noemu/X360toNX/Controller.c

/*
             LUFA Library
     Copyright (C) Dean Camera, 2013.

  dean [at] fourwalledcubicle [dot] com
           www.lufa-lib.org
*/

/*
  Copyright 2013  Dean Camera (dean [at] fourwalledcubicle [dot] com)

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
  The author disclaims all warranties with regard to this
  software, including all implied warranties of merchantability
  and fitness.  In no event shall the author be liable for any
  special, indirect or consequential damages or any damages
  whatsoever resulting from loss of use, data or profits, whether
  in an action of contract, negligence or other tortious action,
  arising out of or in connection with the use or performance of
  this software.
*/

/** \file
 *
 *  Main source file for the DualVirtualSerial demo. This file contains the main tasks of
 *  the demo and is responsible for the initial application hardware configuration.
 */

#include "Controller.h"

/*
The following ButtonMap variable defines all possible buttons within the
original 13 bits of space, along with attempting to investigate the remaining
3 bits that are 'unused'. This is what led to finding that the 'Capture'
button was operational on the stick.
*/
uint16_t ButtonMap[16] = {
  0x01,
  0x02,
  0x04,
  0x08,
  0x10,
  0x20,
  0x40,
  0x80,
  0x100,
  0x200,
  0x400,
  0x800,
  0x1000,
  0x2000,
  0x4000,
  0x8000,
};

/*** Debounce ****
The following is some -really bad- debounce code. I have a more robust library
that I've used in other personal projects that would be a much better use
here, especially considering that this is a stick indented for use with arcade
fighters.
This code exists solely to actually test on. This will eventually be replaced.
**** Debounce ***/
// Quick debounce hackery!
// We're going to capture each port separately and store the contents into a 32-bit value.
uint32_t pb_debounce = 0;
uint32_t pd_debounce = 0;

// We also need a port state capture. We'll use a 16-bit value for this.
uint16_t bd_state = 0;

// We'll also give us some useful macros here.
#define PINB_DEBOUNCED ((bd_state >> 0) & 0xFF)
#define PIND_DEBOUNCED ((bd_state >> 8) & 0xFF) 

// So let's do some debounce! Lazily, and really poorly.
void debounce_ports(void) {
  // We'll shift the current value of the debounce down one set of 8 bits. We'll also read in the state of the pins.
  pb_debounce = (pb_debounce << 8) + PINB;
  pd_debounce = (pd_debounce << 8) + PIND;

  // We'll then iterate through a simple for loop.
  for (int i = 0; i < 8; i++) {
    if ((pb_debounce & (0x1010101 << i)) == (0x1010101 << i)) // wat
      bd_state |= (1 << i);
    else if ((pb_debounce & (0x1010101 << i)) == (0))
      bd_state &= ~(uint16_t)(1 << i);

    if ((pd_debounce & (0x1010101 << i)) == (0x1010101 << i))
      bd_state |= (1 << (8 + i));
    else if ((pd_debounce & (0x1010101 << i)) == (0))
      bd_state &= ~(uint16_t)(1 << (8 + i));
  }
}

// Configures hardware and peripherals, such as the USB peripherals.
void SetupHardware(void) {
  // We need to disable watchdog if enabled by bootloader/fuses.
  MCUSR &= ~(1 << WDRF);
  wdt_disable();

  // We need to disable clock division before initializing the USB hardware.
  clock_prescale_set(clock_div_1);
  // We can then initialize our hardware and peripherals, including the USB stack.

  // Both PORTD and PORTB will be used for handling the buttons and stick.
  //DDRD  &= ~0xFF;
  //PORTD |=  0xFF;

  //DDRB  &= ~0xFF;
  //PORTB |=  0xFF;
  // The USB stack should be initialized last.
  USB_Init();
}

// Fired to indicate that the device is enumerating.
void EVENT_USB_Device_Connect(void) {
  // We can indicate that we're enumerating here (via status LEDs, sound, etc.).
}

// Fired to indicate that the device is no longer connected to a host.
void EVENT_USB_Device_Disconnect(void) {
  // We can indicate that our device is not ready (via status LEDs, sound, etc.).
}

// Fired when the host set the current configuration of the USB device after enumeration.
void EVENT_USB_Device_ConfigurationChanged(void) {
  bool ConfigSuccess = true;

  // We setup the HID report endpoints.
  ConfigSuccess &= Endpoint_ConfigureEndpoint(JOYSTICK_OUT_EPADDR, EP_TYPE_INTERRUPT, JOYSTICK_EPSIZE, 1);
  ConfigSuccess &= Endpoint_ConfigureEndpoint(JOYSTICK_IN_EPADDR, EP_TYPE_INTERRUPT, JOYSTICK_EPSIZE, 1);

  // We can read ConfigSuccess to indicate a success or failure at this point.
}

// Process control requests sent to the device from the USB host.
//remove maybe
void EVENT_USB_Device_ControlRequest(void) {

 
}
